lohjc1023/Minisystem-for-optical-water-purity-detection-URECA/Papers/4-Matls/FireFly-FlowCellRectang.jpg

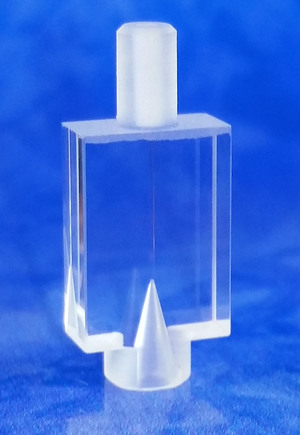
Papers/4-Matls/FireFly-FlowCellRectang.jpg
