lohjc1023/Minisystem-for-optical-water-purity-detection-URECA/README.md

# Minisystem-for-optical-water-purity-detection-URECA
This project, in collaboration with NEWRI, explores the tremendous potential to utilize optical analysis (e.g. UV absorbance and/or fluorescence) to monitor the output of the desalination processes and assess the quality of purified water.
