lohjc1023/Minisystem-for-optical-water-purity-detection-URECA/Papers/4-Matls/OptElems/KnightOpticalReply-NO.txt

From:	Colin Overton <colin.overton@knightoptical.com>
Sent:	Wednesday, 9 June 2021 4:27 PM
To:	Poenar Daniel Puiu (Assoc Prof)
Subject:	FW: Contact Form
Attachments:	#KO_Mini Brochure.pdf; #Metrology Brochure.pdf

Hi Daniel

Thanks for the enquiry, its appreciated.    

I am sorry but we do not have the capacity at the moment to supply this.

But please keep us to mind on all future applications please.
FYI.  All our components are individually QA/ Metrology inspected for quality.  See attached Metrology 
and PDF brochure. :) 
Best regards,
Colin Overton  

Colin Overton 

View Our Catalogue Here | UK Tel: +44 (0)1622 859444 | USA Tel: +1 401-583-7846 | www.knightoptical.com 
Knight Optical (UK) Ltd | Roebuck Business Park | Harrietsham | Kent, ME17 1AB, UK
Knight Optical (USA) LLC | 1130 Ten Rod Road | Suite D-103 | North Kingstown | RI, 02852, USA

The information contained in this communication is intended solely for the use of the individual or entity to whom it is addressed and others authorized to receive it. It may contain confidential or legally privileged information. If you are not the intended recipient you 
are hereby notified that any disclosure, copying, distribution or taking any action in reliance on the contents of this information is strictly prohibited and may be unlawful. If you have received this communication in error, please notify us immediately by responding to 
this email and then delete it from your system. Knight Optical (UK) Limited is neither liable for the proper and complete transmission of the information contained in this communication nor for any delay in its receipt. If we have emailed you as a result of our 
marketing activities and you do not wish to receive further emails from us, please reply to this email with "Remove" in the subject line.

From: Customer Services <customer.services@knightoptical.co.uk>  
Sent: 07 June 2021 12:48 
To: Colin Overton <colin.overton@knightoptical.com> 
Subject: FW: Contact Form

Kind regards,
Rachel Smyth

Rachel Smyth BSc(Hons) 
UK Sales Manager

View Our Catalogue Here | UK Tel: +44 (0)1622 859444 | USA Tel: +1 401-583-7846 | www.knightoptical.com 
Knight Optical (UK) Ltd | Roebuck Business Park | Harrietsham | Kent, ME17 1AB, UK
Knight Optical (USA) LLC | 1130 Ten Rod Road | Suite D-103 | North Kingstown | RI, 02852, USA

The information contained in this communication is intended solely for the use of the individual or entity to whom it is addressed and others authorized to receive it. It may contain confidential or legally privileged information. If you are not the intended recipient you 
are hereby notified that any disclosure, copying, distribution or taking any action in reliance on the contents of this information is strictly prohibited and may be unlawful. If you have received this communication in error, please notify us immediately by responding to 
this email and then delete it from your system. Knight Optical (UK) Limited is neither liable for the proper and complete transmission of the information contained in this communication nor for any delay in its receipt. If we have emailed you as a result of our 
marketing activities and you do not wish to receive further emails from us, please reply to this email with "Remove" in the subject line.

From: Custom 2 <news@latest.knightoptical.com>  
Sent: 07 June 2021 10:35 
To: Customer Services <customer.services@knightoptical.co.uk> 
Subject: Contact Form

Firstname
Daniel
Lastname
Poenar
Name
Daniel Poenar
Email
epdpuiu@ntu.edu.sg
Phone

Mobile

Company
EEE School, NTU, Singapore
Position
Assoc.Prof.
Application/Instrument
Education & Research
Country
SG
Message
Dear Lady/Sir, My name is Poenar Daniel and I am an Assoc.Prof. in the EEE School of 
NTU. I would like to know if you have available or if it is possible for you to fabricate a 
UV-vis long-pass dichroic mirror, although maybe a more appropriate name would be 
edge filter because the ideal desired operation should be for an AOI of 0°, NOT 45° as is 
typical with normal applications for dichroic mirrors (e.g. in a filter cube). The specs for 
this filter are: high reflectivity (R>90%) in the UV (between 230 nm and 380 or400 nm) 
and high transmissivity (T>90%) in the visible range (between approx.380 or 400 nm and 
750...780 nm). If the latter too tough (i.e. too difficult/impossible to reconcile both 
rejection & transmission windows requirements/bandwidths simultaneously), the vis 
range transmission window's long wavelength limit can be reduced down from 750/780 
nm to 600 nm or even 550 nm if really necessary. If you have/can do it, then please 
kindly send me quotation for it, including the cost of packaging & shipping. Thank you for 
your help and am looking forward for your quick feedback ! With best wishes, Poenar 
Daniel
Thank you, Knight Optical!
