lohjc1023/Minisystem-for-optical-water-purity-detection-URECA/Papers/4-Matls/OptElems/FiltersCurves.pptx

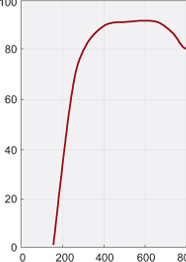
[picture p28: figure]

Eksma UV Al protected mirror

230

250

300

340

## Slide 2

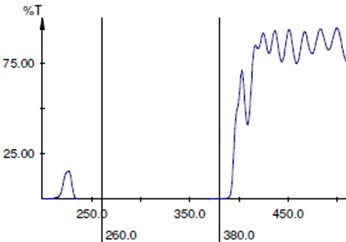
[picture p29: figure]
