lohjc1023/Minisystem-for-optical-water-purity-detection-URECA/Papers/4-Matls/VitroCom_ArteGlass-TransmissCurvesQuartz&Borosilicate.pdf

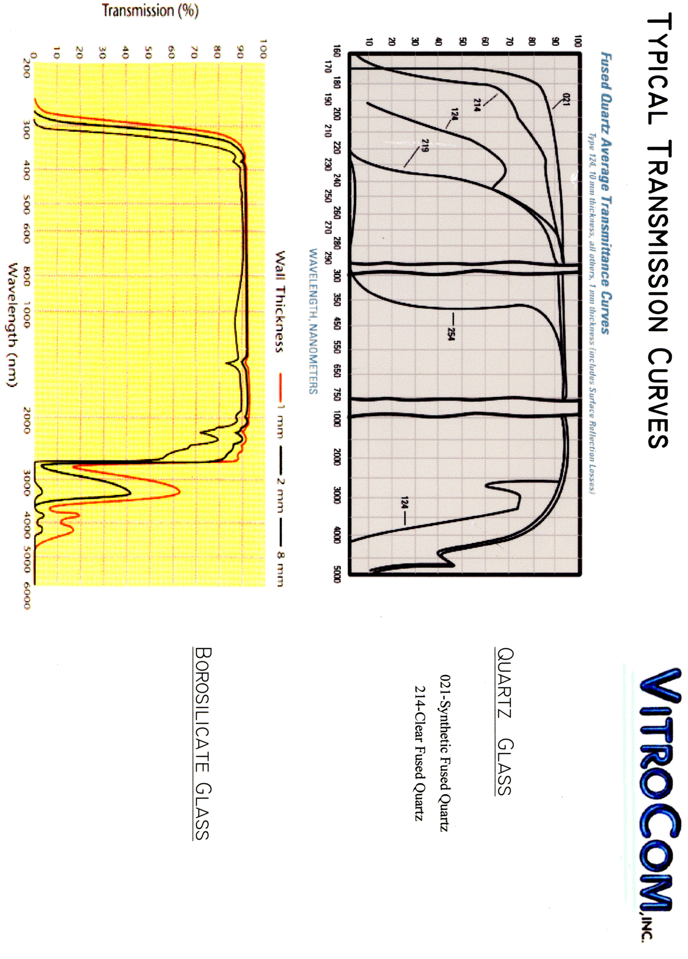
[picture p30: page 1]
