lohjc1023/Minisystem-for-optical-water-purity-detection-URECA/Papers/4-Matls/VitroCom_ArteGlassJapan-DrawingFlowcell.pdf

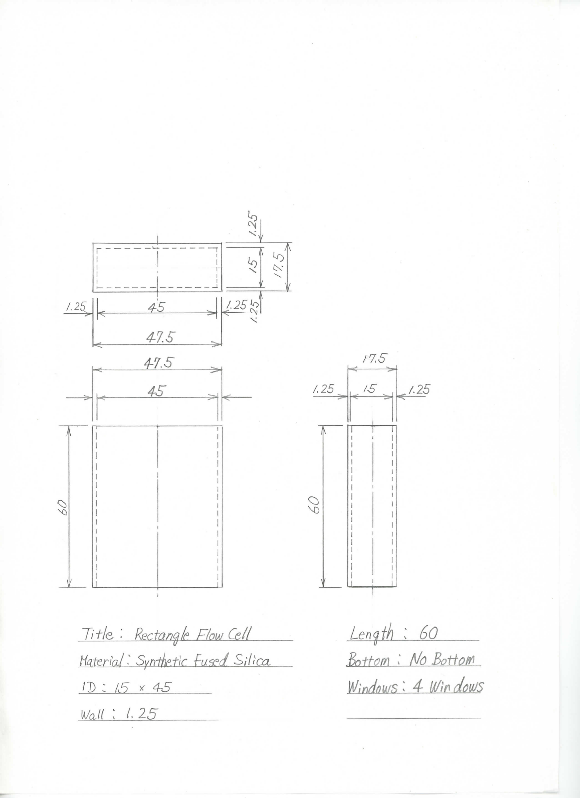
[picture p31: page 1]

鴫 劔箸

I　　　　　　＼

／．25 X耳耳耳耳自?耳耳耳耳耳R亦亦＼∃き、

i I ｢

I

）
i＼ 　享言∴∴＿ ‾、ヽ | 考古 倅

し∴∴∴4岬．5°∴∴、＿，

薯

一き | タ‾‾ | 4肯 |

I ーi a　各 日！ 昌3‡ ii li i出 il il
