lohjc1023/Minisystem-for-optical-water-purity-detection-URECA/Papers/4-Matls/OptElems/EdmundOpticsDichroicFilter.xlsx

Sheet: Data 1
200 | 0.00842 | 0.00058 | 0.01625
201 | 0.01208 | 0.00093 | 0.02323
202 | 0.01624 | 0.00156 | 0.03092
203 | 0.01982 | 0.00267 | 0.03697
204 | 0.02272 | 0.00432 | 0.04113
205 | 0.02551 | 0.00612 | 0.0449
206 | 0.02842 | 0.00772 | 0.04912
207 | 0.03136 | 0.00933 | 0.05339
208 | 0.03405 | 0.01119 | 0.0569
209 | 0.03635 | 0.01326 | 0.05943
210 | 0.03831 | 0.01524 | 0.06138
211 | 0.04004 | 0.01696 | 0.06313
212 | 0.04153 | 0.01846 | 0.06461
213 | 0.04263 | 0.01984 | 0.06542
214 | 0.04321 | 0.02103 | 0.06539
215 | 0.04337 | 0.02189 | 0.06485
216 | 0.0434 | 0.02243 | 0.06437
217 | 0.04362 | 0.02284 | 0.0644
218 | 0.0442 | 0.02339 | 0.06501
219 | 0.04501 | 0.02419 | 0.06583
220 | 0.04572 | 0.02516 | 0.06627
221 | 0.04592 | 0.02602 | 0.06581
222 | 0.0454 | 0.02643 | 0.06437
223 | 0.04428 | 0.02623 | 0.06232
224 | 0.04291 | 0.02558 | 0.06025
225 | 0.04172 | 0.02479 | 0.05864
226 | 0.04097 | 0.0242 | 0.05775
227 | 0.04079 | 0.02399 | 0.05758
228 | 0.04109 | 0.02422 | 0.05797
229 | 0.0417 | 0.02482 | 0.05858
230 | 0.04234 | 0.02565 | 0.05904
231 | 0.04275 | 0.02646 | 0.05904
232 | 0.04275 | 0.02701 | 0.05849
233 | 0.04236 | 0.02717 | 0.05754
234 | 0.0417 | 0.02696 | 0.05645
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
