lohjc1023/Minisystem-for-optical-water-purity-detection-URECA/Papers/4-Matls/OptElems/ThorlabsAlMirrorsComparData.xlsx

 | A Comparisons of Thorlabs' Thin Film Aluminum Mirror Coatings
 | UV-Enhanced Aluminum (-F01) |  | Protected Aluminum (-G01)
 | Wavelength (µm) | Reflectance (%) | Wavelength (µm) | Reflectance (%)
 | 0.22 | 76.41042 | 0.23 | 32.05956
 | 0.23 | 81.55065 | 0.24 | 12.79264
 | 0.24 | 85.14807 | 0.25 | 16.80748
 | 0.25 | 87.71277 | 0.26 | 24.80127
Product Raw Data | 0.26 | 89.4545 | 0.27 | 33.42666
Aluminum Coating Reflectance, 45° AOI | 0.27 | 90.71416 | 0.28 | 39.33633
 | 0.28 | 91.39173 | 0.29 | 40.28095
DISCLAIMER: The data presented here are typical. Slight variations in performance data will occur from lot to lot. Please contact Technical Support with any questions regarding the use or reliability of this data. | 0.29 | 92.33741 | 0.3 | 40.25924
 | 0.3 | 92.60458 | 0.31 | 39.47243
 | 0.31 | 92.71703 | 0.32 | 39.29734
 | 0.32 | 92.791 | 0.33 | 41.82419
 | 0.33 | 92.83171 | 0.34 | 49.60088
 | 0.34 | 92.71302 | 0.35 | 61.03755
This data may be used in publications. However, please cite Thorlabs as the source. | 0.35 | 92.60392 | 0.36 | 71.53332
 | 0.36 | 92.44154 | 0.37 | 79.17197
 | 0.37 | 92.2634 | 0.38 | 83.85685
Additional Information: | 0.38 | 92.01947 | 0.39 | 86.73133
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
