lohjc1023/Minisystem-for-optical-water-purity-detection-URECA/Electrical System Design/Finalise PCBs/Differential Amplifier.png

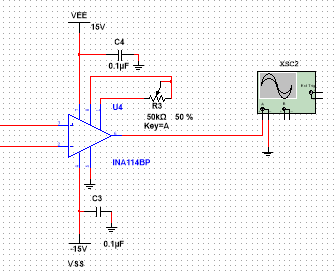
Electrical System Design/Finalise PCBs/Differential Amplifier.png
