lohjc1023/Minisystem-for-optical-water-purity-detection-URECA/Electrical System Design/Finalise PCBs/filter bode diagram.png

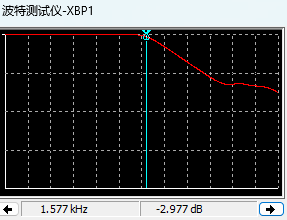
Electrical System Design/Finalise PCBs/filter bode diagram.png
