lohjc1023/Minisystem-for-optical-water-purity-detection-URECA/Electrical System Design/Finalise PCBs/Lock-in amplifier input.png

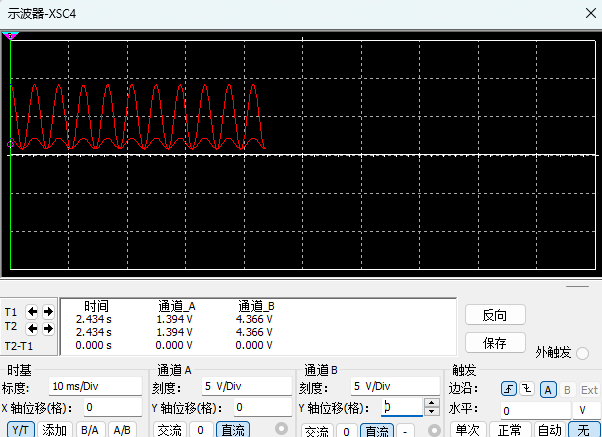
Electrical System Design/Finalise PCBs/Lock-in amplifier input.png
