lohjc1023/Minisystem-for-optical-water-purity-detection-URECA/Electrical System Design/Finalise PCBs/lock-in amplifier output.png

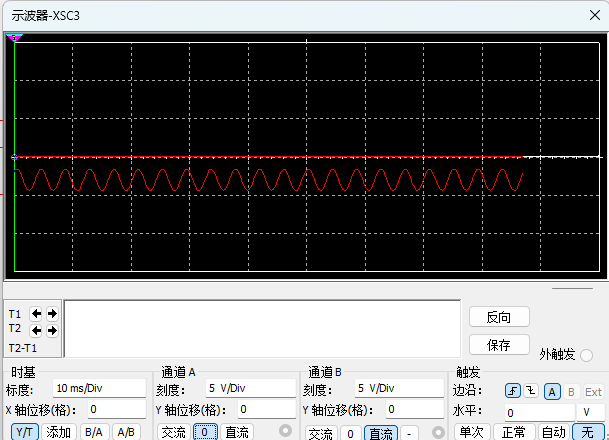
Electrical System Design/Finalise PCBs/lock-in amplifier output.png
