lohjc1023/Minisystem-for-optical-water-purity-detection-URECA/Electrical System Design/Finalise PCBs/LOW.png

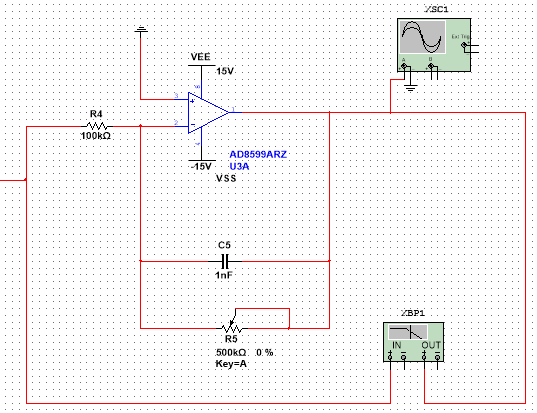
Electrical System Design/Finalise PCBs/LOW.png
