lohjc1023/Minisystem-for-optical-water-purity-detection-URECA/Electrical System Design/Finalise PCBs/PCB 3DImages/PCB for Reference Holder Photodiodes.png

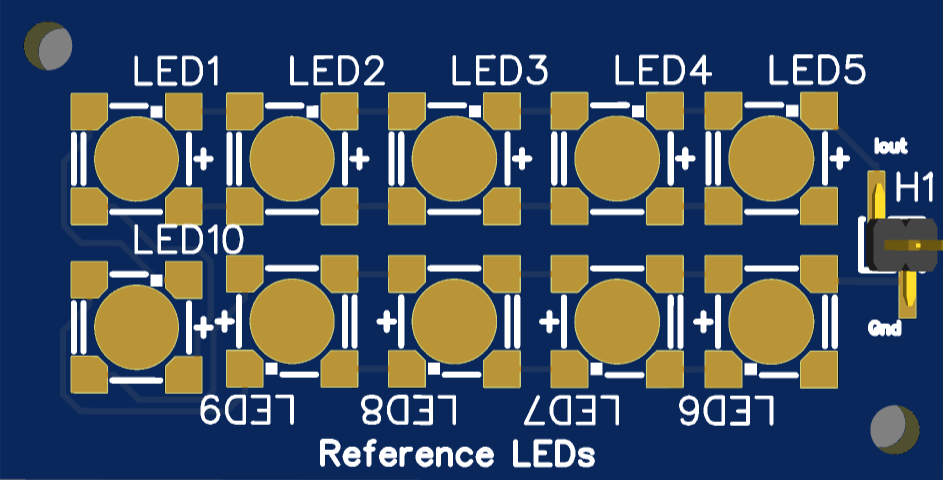
Electrical System Design/Finalise PCBs/PCB 3DImages/PCB for Reference Holder Photodiodes.png
