lohjc1023/Minisystem-for-optical-water-purity-detection-URECA/Electrical System Design/Finalise PCBs/PMT.png

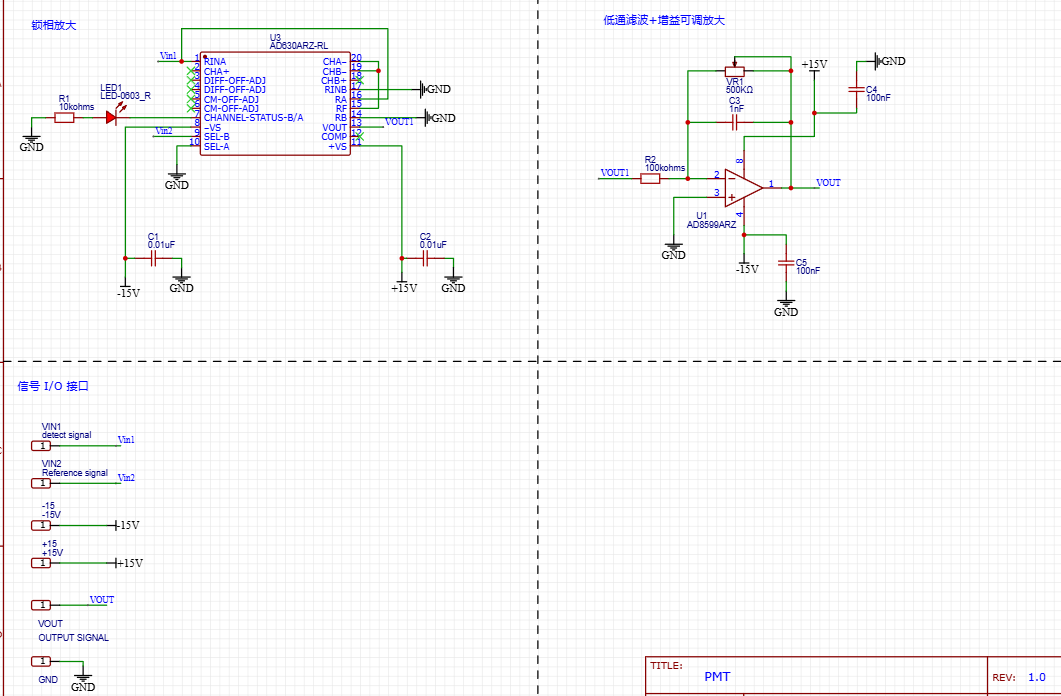
Electrical System Design/Finalise PCBs/PMT.png
