lohjc1023/Minisystem-for-optical-water-purity-detection-URECA/Electrical System Design/Finalise PCBs/Reference TIA.png

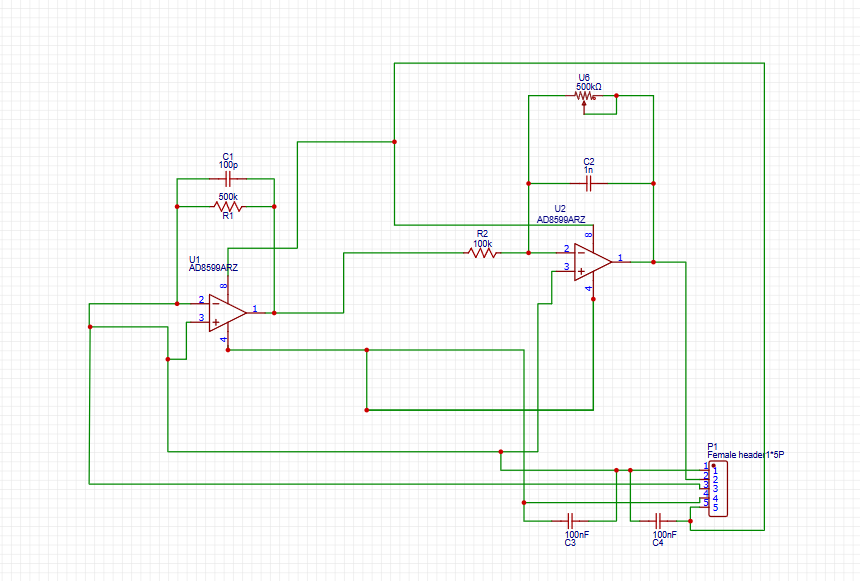
Electrical System Design/Finalise PCBs/Reference TIA.png
