lohjc1023/Minisystem-for-optical-water-purity-detection-URECA/Electrical System Design/Finalise PCBs/sinewave1.png

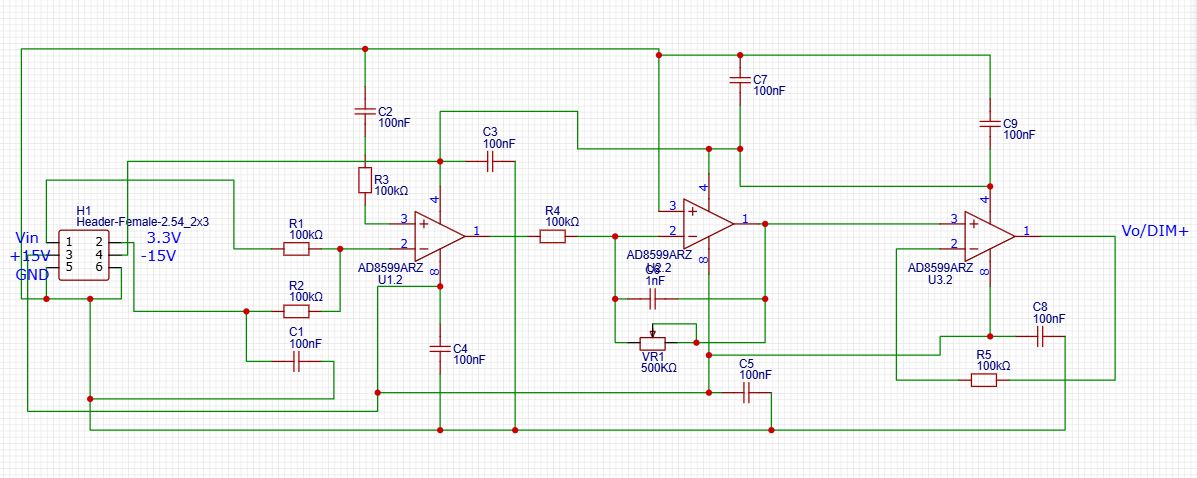
Electrical System Design/Finalise PCBs/sinewave1.png
