lohjc1023/Minisystem-for-optical-water-purity-detection-URECA/Electrical System Design/Finalise PCBs/Transmission and Reference TIA.png

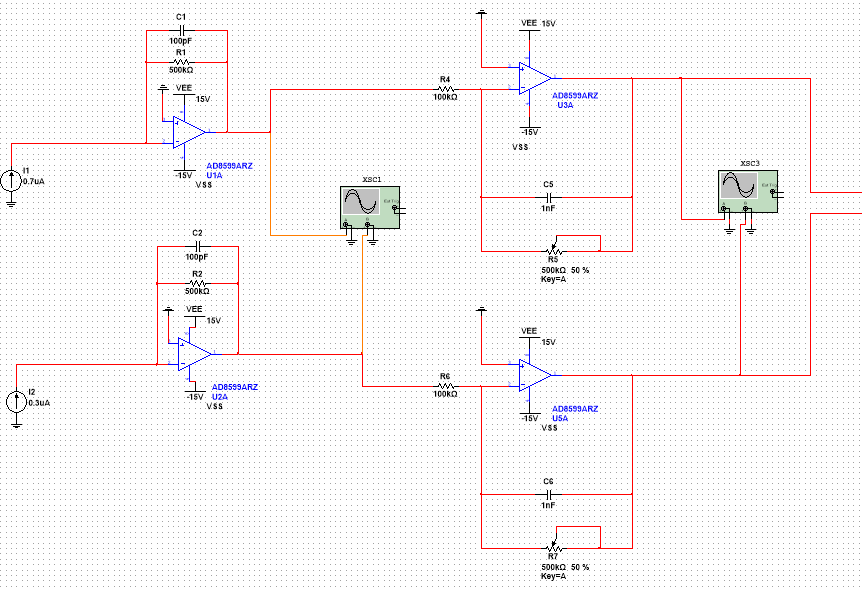
Electrical System Design/Finalise PCBs/Transmission and Reference TIA.png
