lohjc1023/Minisystem-for-optical-water-purity-detection-URECA/Electrical System Design/Finalise PCBs/transmission TIA .png

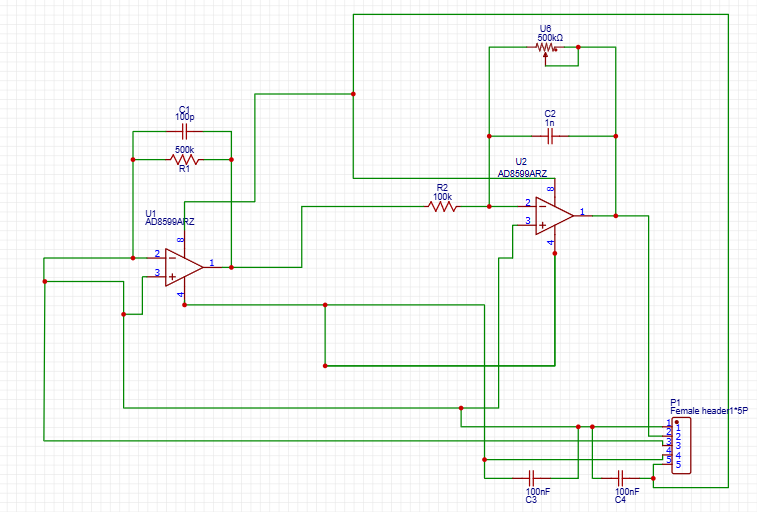
Electrical System Design/Finalise PCBs/transmission TIA .png
