lohjc1023/Minisystem-for-optical-water-purity-detection-URECA/Papers/4-Matls/BorofloatBSGsTransmission.png

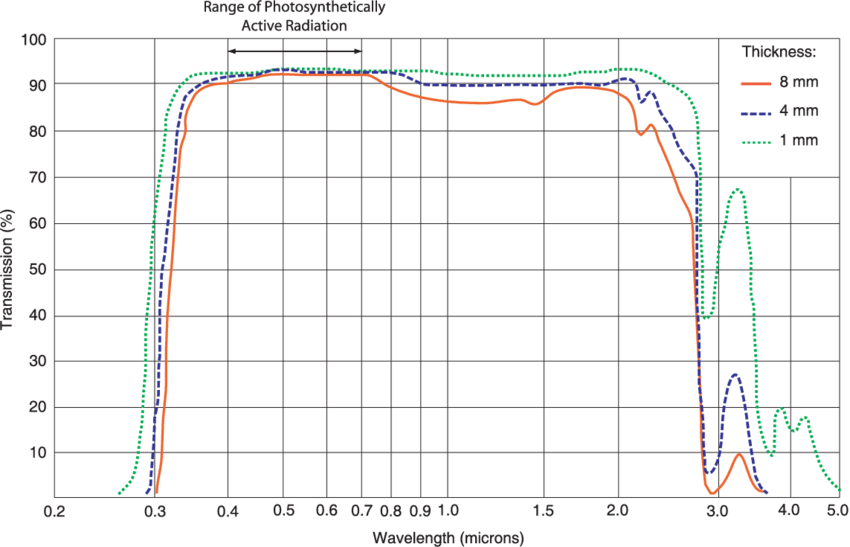
Papers/4-Matls/BorofloatBSGsTransmission.png
