lohjc1023/Minisystem-for-optical-water-purity-detection-URECA/Papers/4-Matls/FusedQuartzTransmittance-TechnicalGlassProducts.gif

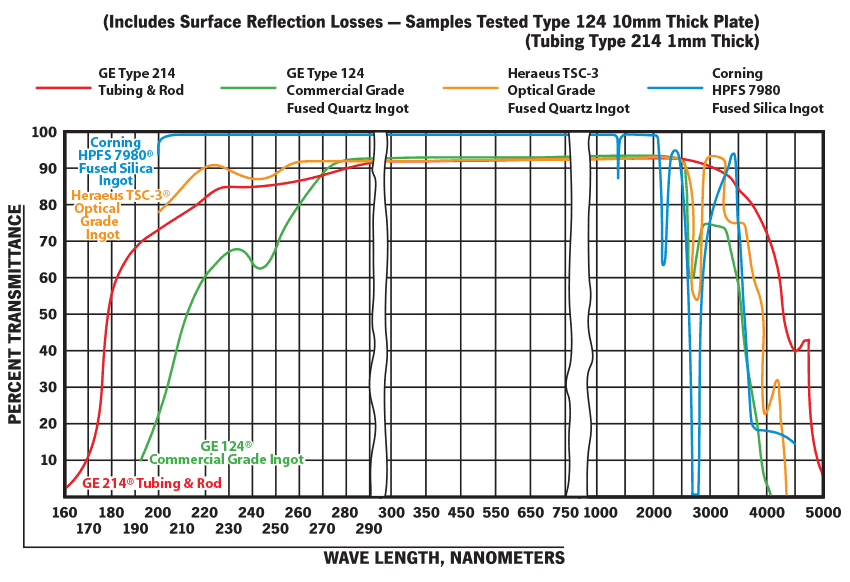
Papers/4-Matls/FusedQuartzTransmittance-TechnicalGlassProducts.gif
