lohjc1023/Minisystem-for-optical-water-purity-detection-URECA/Papers/4-Matls/LightSources/Newport-XeArcLamp150W.gif

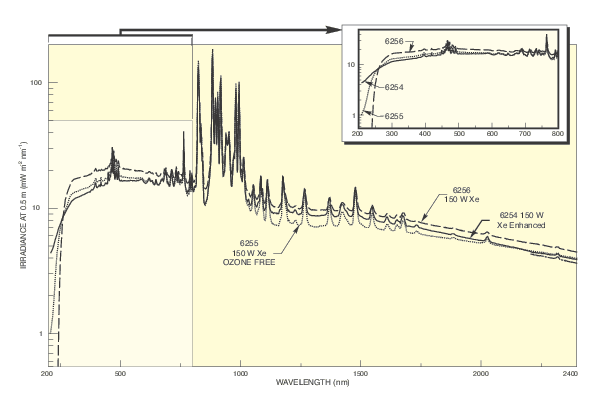
Papers/4-Matls/LightSources/Newport-XeArcLamp150W.gif
