lohjc1023/Minisystem-for-optical-water-purity-detection-URECA/Papers/4-Matls/OptElems/EdmundFiberBundle57-070.gif

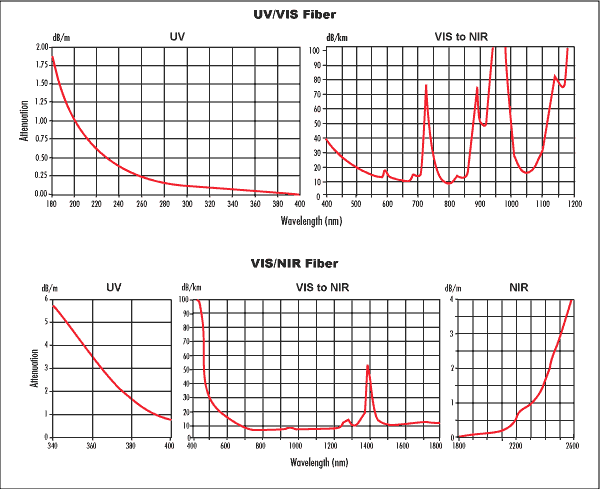
Papers/4-Matls/OptElems/EdmundFiberBundle57-070.gif
