lohjc1023/Minisystem-for-optical-water-purity-detection-URECA/Papers/4-Matls/OptElems/EksmaDielMirror280-400nm.jpg

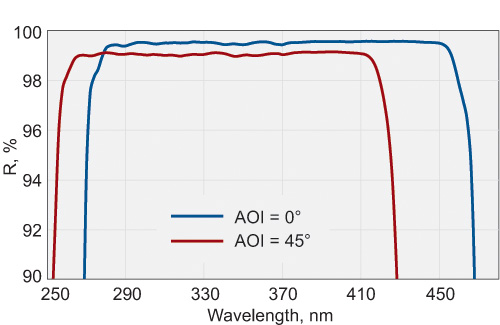
Papers/4-Matls/OptElems/EksmaDielMirror280-400nm.jpg
