lohjc1023/Minisystem-for-optical-water-purity-detection-URECA/Papers/4-Matls/OptElems/FusedSilica&QuartzTransm-ESCO.png

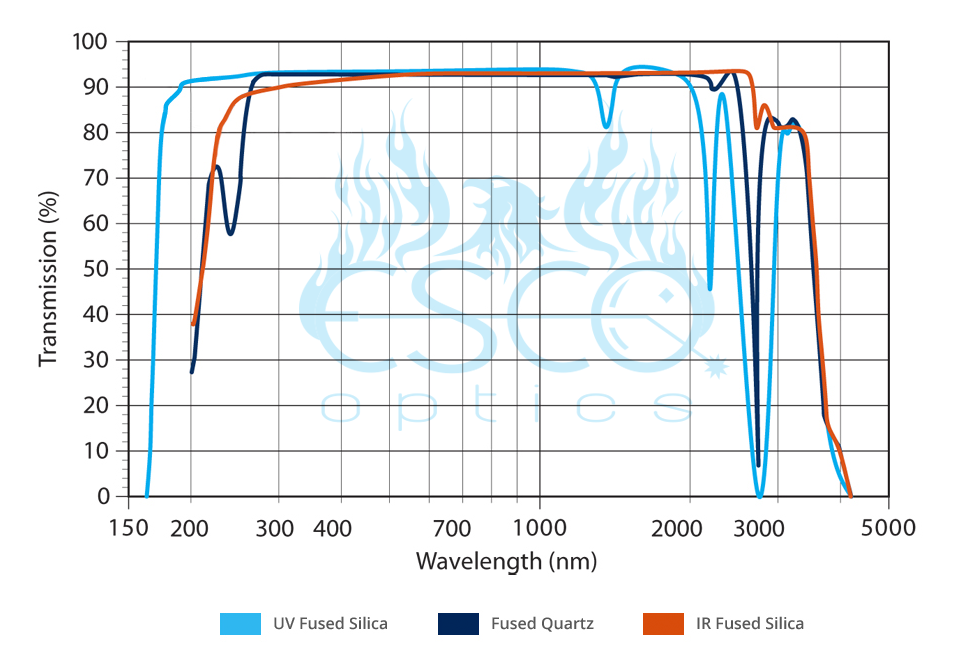
Papers/4-Matls/OptElems/FusedSilica&QuartzTransm-ESCO.png
