lohjc1023/Minisystem-for-optical-water-purity-detection-URECA/Papers/4-Matls/OptElems/ReflectivityAlBare.gif

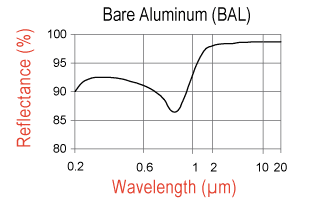
Papers/4-Matls/OptElems/ReflectivityAlBare.gif
