lohjc1023/Minisystem-for-optical-water-purity-detection-URECA/Mechanical System Design/Main 2.0 v32.stl

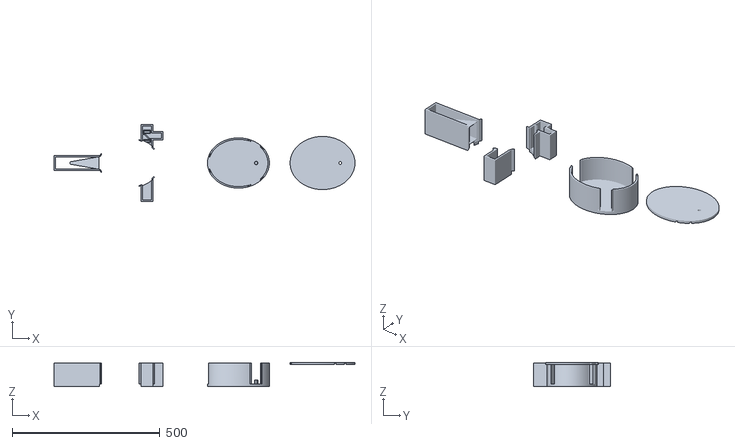
[picture p62: CAD file, 2025-11-16]
Mechanical System Design/Main 2.0 v32.stl
1020.0 x 260.0 x 83.0
