lohjc1023/Minisystem-for-optical-water-purity-detection-URECA/Mechanical System Design/Finalise_CAD .stl

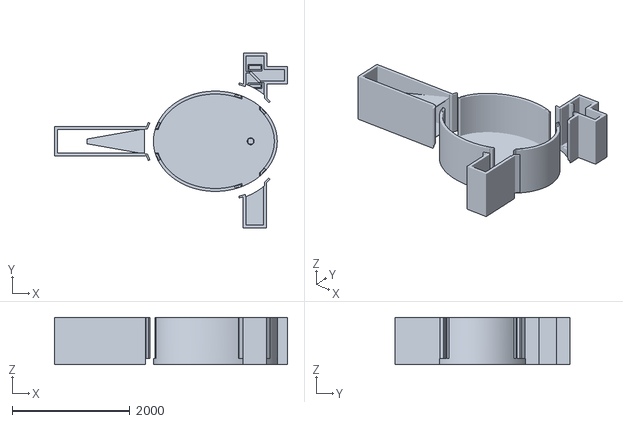
[picture p63: CAD file, 2025-11-16]
Mechanical System Design/Finalise_CAD .stl
3949.3 x 2963.4 x 800.0
