lohjc1023/Minisystem-for-optical-water-purity-detection-URECA/Papers/4-Matls/LightSources/LampSelectGuide-HamamatsuFig3.jpg

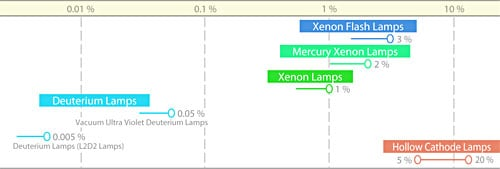
Papers/4-Matls/LightSources/LampSelectGuide-HamamatsuFig3.jpg
