lohjc1023/Minisystem-for-optical-water-purity-detection-URECA/Papers/4-Matls/LightSources/SuntechLED-255nmUVCtestReport.txt

From:	sale3@suntechleds.com
Sent:	Monday, 31 May 2021 4:53 PM
To:	Poenar Daniel Puiu (Assoc Prof)
Cc:	mark
Subject:	Re: Re: 255 nm UVC LED chips, 275 nm and 340 nm UV chip
Attachments:	255nm uvc test report.pdf

Dear Prof. Poenar,

The test report of the 255nm UVC LED chip are attached for reference.

Feel free to conatct us if any furthere requirements, thank you.

Appreciated for your reply.
 
Yours sincerely
Anny
 
Sales
 
Mobile&Whatsapp: +86 17767710212
E-mail: sale3@suntechleds.com
Skype: sale3@suntechleds.com 
Web: www.suntechleds.com  www.mmmled.com 
Add: 6th floor, D Building, Shuitian Dingfeng Techpark, Shiyan Town, Baoan, Shenzhen, China.
Shenzhen Suntech Company Limited

From: sale3@suntechleds.com
Date: 2021-05-29 12:13
To: epdpuiu
CC: mark
Subject: Re: Re: 255 nm UVC LED chips, 275 nm and 340 nm UV chip
Dear Prof. Poenar,

For your inquiry, we provide 255nm, 275nm and 340nm UV chip and the 225nm UVC chip is not 
avaliable.

Please check the attached product specifications of 255nm and 275nm UVC LED chip. 
The 340nm LED chip is not the regular product we offer, we will customize this model for you.

Would you please inform us how many unit you need? So the quotation and cost for the shipment 
will be provided.

Pleae contact us if any questions. Have a nice day!

Yours sincerely
Anny
 
Sales
 
Mobile&Whatsapp: +86 17767710212
E-mail: sale3@suntechleds.com
Skype: sale3@suntechleds.com 
Web: www.suntechleds.com  www.mmmled.com 
Add: 6th floor, D Building, Shuitian Dingfeng Techpark, Shiyan Town, Baoan, Shenzhen, China.
Shenzhen Suntech Company Limited

From: sale3@suntechleds.com
Date: 2021-05-28 22:39
To: epdpuiu
CC: mark
Subject: Re: 255 nm UVC LED chips, 275 nm and 340 nm UV chip
Dear Poenar,

This is Anny from Suntech, thanks for your inquiry.

Due to it is late night here and it's not convenient for me to send the details to you, I will 
reply you tomorrow.

Thanks for your understanding. Happy weekends!

Yours sincerely
Anny
 
Sales
 
Mobile&Whatsapp: +86 17767710212
E-mail: sale3@suntechleds.com
Skype: sale3@suntechleds.com 
Web: www.suntechleds.com  www.mmmled.com 
Add: 6th floor, D Building, Shuitian Dingfeng Techpark, Shiyan Town, Baoan, Shenzhen, 
China.
Shenzhen Suntech Company Limited

Title:
Assoc.Prof.
Content:
Dear Lady/Sir, 
My name is Poenar Daniel and I am an Assoc. Prof. in the School of Electrical & Electronical Engineering (EEE) of the Nanyang Technology University (NTU), Singapore. I would like to request for a quotation for your 225 and 255 nm UVC LED chips. If you also have UV LED chips with peak emission wavelength at 275 nm and 340 nm, please include them in the quotation as well. Also please add the cost for the shipment. Thank you for your time and consideration, and am looking forward for your quick feedback with the quotation! 
With best wishes, 
Poenar Daniel
Name:POENAR Daniel
Inquiry address:https://www.suntechleds.com/regular-led-strip/uv-led-strip-light/250nm-254nm-255nm-260nm-uvc-led-chip-strip.html
Company:EEE School, NTU, Singapore
E-mail:epdpuiu@ntu.edu.sg
Phone:
Source IP:116.88.213.19
Source country:Singapore
Time:05/28/2021 8:27:36 PM
