lohjc1023/Minisystem-for-optical-water-purity-detection-URECA/(list of files, drawings)

Other design files:
Electrical System Design/Multisim Circuit Simulation/PMT 信号调理电路.ms14
Electrical System Design/Multisim Circuit Simulation/参考端 透过支架 信号调理电路.ms14
Electrical System Design/Multisim Circuit Simulation/噪声源信号加入.ms14
Electrical System Design/Multisim Circuit Simulation/电压偏置放大及跟随电路.ms14
