lohjc1023/Minisystem-for-optical-water-purity-detection-URECA/(commit log)

2025-11-16 Upload Elec. Design
    [PMT 信号调理电路.ms14, 参考端 透过支架 信号调理电路.ms14, 噪声源信号加入.ms14, 电压偏置放大及跟随电路.ms14]
2025-11-16 Upload Mech. Design
    [Finalise_CAD .stl, Main 2.0 v32.stl]
2025-11-16 Lit.Review Materials
    [EdmundOpticsDichroicFilter.xlsx, ThorlabsAlMirrorsComparData.xlsx]
